M-Tonin/monitoramento_indoor/README.md

# Monitoramento Indoor 

* **Local**: Sala do IBTI
* **Descrição**: Com uso de dois dispositivos, monitorar a temperatura e a luminosidade em dois pontos diferentes, apresentando os dados em uma aplicação mobile. O dispositivo também deve ser capaz de acionar o buzzer se for solicitado.

Para cada parte do projeto, foi criado uma pasta que deve ser utilizada para o desenvolvimento da solução. **Não devem ser criados novos repositórios**.

* Cada parte do projeto tem suas restrições, a serem esclarecidas com o solicitante.

* Algumas delas podem ser definidas pelas equipes (mas devem ser comunicadas e estão sujeitas a aprovação).

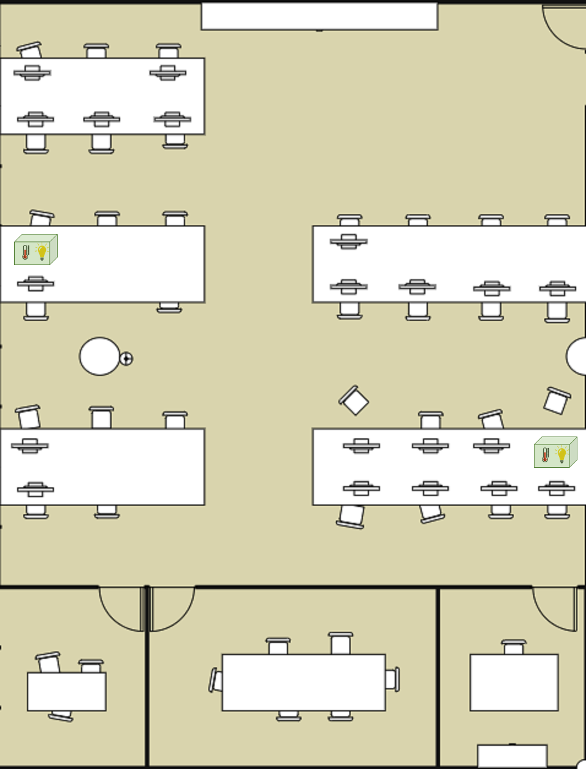
[picture p1: Imagens/SalaCompleta.png]


* **Organização** deve ser feita com Trello.
* **Metodologia** Scrum.
* **Equipes**:
  * Device + Comunicação - 2 pessoas
  * Servidor - 3 pessoas
  * Aplicação - 2 pessoas
  * Scrum Master - 1 pessoa não exclusivo, elegível pela equipe.
  
* Scrum Master deve definir como se dará as reuniões da equipe, bem como o planejamento.
* Datas:
  * Primeira entrega: 19/06/2020
  * Entrega final:  24/06/2020
  * Reuniões com os clientes podem ser marcadas pelas equipes para esclarecimentos e dúvidas
* Cada equipe deve documentar o projeto e apresentar para as outras equipes bem como para os clientes.
 * Primeiros passos:
  * Após a divisão, cada equipe pode (deve) conversar individualmente com os clientes para solicitar mais informações, sanar dúvidas e et cetera.
  * Organização do trello.
  * Atualização do gitignore (na raiz do projeto) a fim de não gerar arquivos inúteis.
  * Atualização do readme dentro da pasta correspondente. 

* É importante que cada equipe comunique com as outras. 

Demais questionamentos devem ser tratados com solicitante.

**Não deve ser feitos commits direto na master, deve ser feito por Pull Request**

**Recomenda-se que cada equipe crie pelo menos uma branch**

**Recomenda-se que antes de mais nada desenhe o fluxo da solução**

**Deve-se documentar os requisitos**

**Novas solicitações podem surgir durante o projeto**
