M-Tonin/monitoramento_indoor/servidor/Monitoramento_Indoor_Modelo_Dados.pdf

Fri Aug 21 19:00:14 2020, New Model - EER Diagram (part 1 of 2)

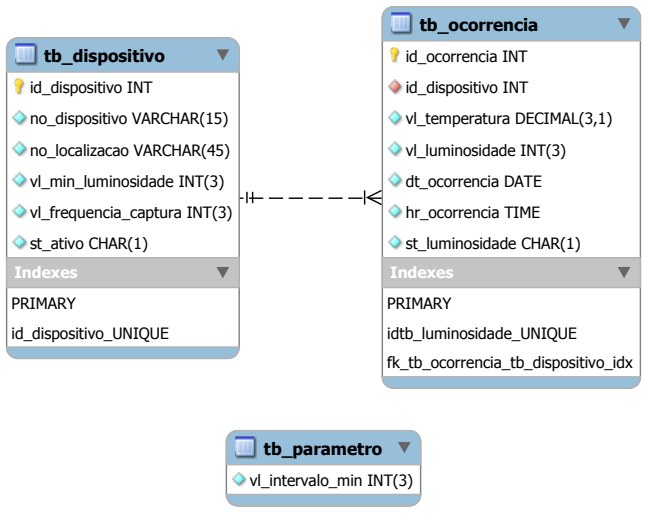
[picture p6: figure]
tb_dispositivo; id_dispositivo INT; no_dispositivo VARCHAR(15); no_localizacao VARCHAR(45); vl_min_luminosidade INT(3); vl_frequencia_captura INT(3); st_ativo CHAR(1); Indexes; PRIMARY; id_dispositivo_UNIQUE; tb_ocorrencia; id_ocorrencia INT; vl_temperatura DECIMAL(3,1); vl_luminosidade INT(3); dt_ocorrencia DATE; hr_ocorrencia TIME; st_luminosidade CHAR(1); idtb_luminosidade_UNIQUE; fk_tb_ocorrencia_tb_dispositivo_idx; tb_parametro; vl_intervalo_min INT(3)

tb_sumario
id_dispositivo INT
dt_ocorrencia DATE
hr_ocorrencia TIME
hr_diferenca_luminosidade TIME

Fri Aug 21 19:00:14 2020, New Model - EER Diagram (part 2 of 2)
