M-Tonin/monitoramento_indoor/aplicacao/src/assets/images/IBTI-Tratado.png

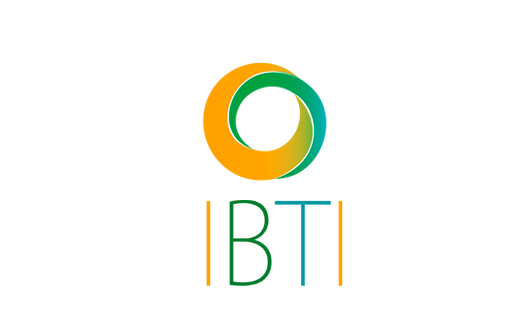
aplicacao/src/assets/images/IBTI-Tratado.png
