M-Tonin/monitoramento_indoor/aplicacao/src/assets/images/lineGraphic.png

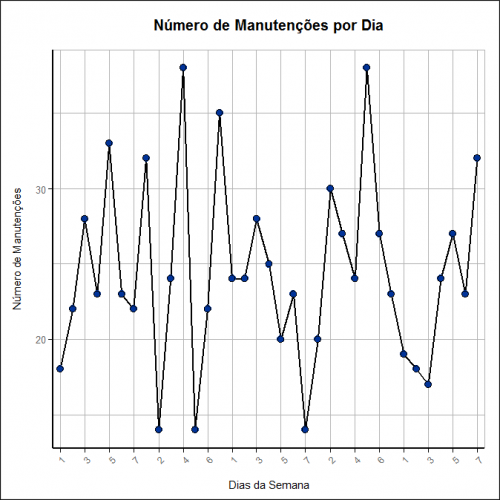
aplicacao/src/assets/images/lineGraphic.png
