M-Tonin/monitoramento_indoor/(commit log)

2020-06-09 Primeiras definições
    -> Responsáveis pela equipe;
    -> Recursos que serão utilizados.
2020-06-15 Uptade + Log de Erros
    -> Update no código ttn-server;
    -> Implementada uma mini interface para manter a conexão e melhorar o uso das funções do servidor;
    -> Adicionado o log de erros.
2020-06-15 Modelo de Dados
2020-06-15 Modelo de Dados - Retificação
2020-06-16 Script do banco e lib de conexão com o banco
2020-06-16 Atualização do script do banco de dados
2020-06-16 Atualização no script do banco de dados
2020-06-17 Atualização do modelo de dados
2020-06-17 Remoção da coluna 'st_luminosidade' de 'tb_ocorrencia''
2020-06-17 Update do Server
    -> Faz conexão com a TTN;
    -> Faz conexão com o banco;
    -> Recebe dados do dispositivo;
    -> Insere os dados recebidos diretamente ao banco;
    -> Implementada uma interface de execução por comandos de terminal.
2020-06-18 Downlink Send FIx
    -> Função de downlink funcionando propriamente agora; payload chega na TTN.
2020-06-18 Alteração no modelo de dados
2020-06-19 Atualização do banco de dados
2020-06-23 WebSocket server
    -> Adicionada a primeira versão do servidor que faz a conexão WiFi
2020-06-23 Testando servidor com Flask
    -> server.py: novo servidor mais simples e prático, usando flask para lidar com a parte de websocket
    -> server_utils.py: biblioteca que fiz para tratar toda a parte de ttn, mysql e bytes
    -> * EM FASE DE TESTES
2020-06-23 Atualização
    -> mySql_Server.py: adicionada a classe de ocorrência
    -> server_utils.py: externalizado o limiar de luminosidade para uma variável para que possa ser editável
2020-06-24 Banco de dados mais recente
2020-06-24 Passando arquivos de teste
2020-06-25 Pequenas alterações
    -> server.py e server_utils.py
    -> organização do código para facilitar a leitura
    -> justes na função 'answer'
2020-06-26 Update
    -> server_utils agora importa mySqlLib_Server e não usa mais o objeto para fazer insert
    -> server.py: indentação, removida uma biblioteca que não estava mais em uso 'codecs'
2020-06-26 Correção de erros no script
2020-06-26 Subindo Arquivos
    -> Todos os 5 arquivos principais do servidor e mais o pdf com o modelo de dados para o /master
2020-06-29 Versão Final
    -> todas as rotas estão funcionando e realizando operações no banco de dados e nos dispositivos devidamente
    -> todas as respostas são em json propriamente indentadas
    -> o servidor agora roda em flask + ngrok até 8h seguidas. a adição da biblioteca ngrok foi recomendação para testes remotos. para um release 24/7 será necessário remover ngrok
    -> adicionada uma função de downlink para o dispositivo LoRa na biblioteca server_utils.py
2020-07-06 Update server_utils.py
    -> Função 'callSendToTTN' agora propriamente recebe e trata o downlink antes de enviar pra TTN
2020-07-07 Correção de comando SQL
2020-07-07 correção dos metodos temperatures
2020-07-10 Atualizando para Minutos
2020-07-10 Update no Servidor
    -> adicionados / ajustados diversos comentários no código para melhorar legibilidade e entendimento
    -> pequenos ajustes para melhorar a legibilidade do código
    -> removida a rota root de debug (retornava apenas 'DEBUG-')
    -> adicionado o tratamento de erros em todas as rotas que devem receber dados
    -> modificado o código de erro retornado caso não haja informações a serem lidas para '204 - no content'
    -> reduzido o limiar de luminosidade para 70
    -> ajustada a função de uplink callback da ttn para retornar apenas lux e temperatura recebidas do dispositivo em vez do payload inteiro bruto
2020-07-10 Script para inserção de dados de teste ou provisórios
2020-07-10 Teste Sensores
2020-07-10 Início de Documentação
2020-07-10 Inserção do limite de registros em 144
2020-07-11 Subindo para o master
2020-07-13 Arrumando Interrupção para 10 min
2020-07-14 Remoção de Arquivos
    -> Removidos 4 arquivos que não vinham mais sendo utilizados já faz um tempo
2020-07-14 Pontes de Conexão
    -> adicionada a img que esquematiza as pontes de conexão do servidor
2020-07-14 Pontes de conexão do servidor
    -> movido o arquivo para a pasta correta
2020-07-14 Esquema circuitos
2020-07-15 Add files via upload
    Documentação ref. a modelagem de dados projetos monitoramento indoor
2020-07-15 Update de Frequências Sincronizado
    -> feito o update de frequências no banco de dados durante os uplinks de ambos os dispositivos
    -> os dispositivos recebem downlinks quando enviam uplinks, mas o servidor mandava o update pro banco já no downlink, causando dissincronia
    -> este update afeta os dois arquivos 'server.py' e 'server_utils.py'
    -> precisa ser testado
2020-07-16 Responses
    -> substituído o uso da 'util.answer' quando a resposta não é um 'dict' para 'return jsonify'
2020-07-16 Ajustes na função que atualiza a frequência dos dispositivos no banco de dados
2020-07-17 Update readme.md
    -> adicionando informações sobre o banco de dados
2020-07-17 Correção da mensagem de atualização da frequência
2020-08-21 Correção na inserção de dados provisórios.
2020-08-21 Inserção da tabela de sumário
2020-09-01 Tratamento de erros
    -> vários blocos de código modificados para fazer melhor tratamento de erros
    -> adicionado o código de erro 404 quando o servidor não encontra no banco de dados uma informação requisitada pela aplicação
    -> padronizadas todas as respostas enviadas à aplicação; todas agora incluem http code
2020-09-01 Correção de erros
2020-09-03 Correção de erro
    -> erro de downlink
2020-09-03 Correção de erros
    -> respostas dos novos excepts estavam inadequadas
2020-09-04 Erro de Downlink Corrigido
    -> o servidor estava zerando a variável que guarda a nova frequência de envio do dispositivo logo após a inserção no banco, antes do return, o que fazia com que ele retornasse sempre 0 para o dispositivo
    -> o manuseio desta variável é feito apenas no programa principal agora
    -> variável zerada apenas depois do return, garantindo que todo o processamento seja devidamente feito antes disso
2020-09-04 Removendo logs
    -> removendo console logs já que os testes já foram concluídos
2020-09-04 Downlink
    -> corrigido o servidor mandando comando para o dispositivo mudar de frequência em todos os envios diferente de 0
2020-09-24 Update readme.md
    -> adicionada uma sessão de problemas encontrados;
